BrayLab60/Tracker-Solaire/README.md

# Solar Tracker Toolkit 🌞
Bienvenue dans le Solar Tracker Toolkit, une aventure technologique où la créativité rencontre la durabilité. Ce kit a été spécialement conçu pour vous guider pas à pas dans la conception, l'assemblage et la programmation de votre propre système de suivi solaire automatisé.

À travers une approche pratique et collaborative, vous apprendrez à maîtriser toutes les étapes de fabrication d’un tracker solaire performant, en utilisant des matériaux recyclés et des technologies accessibles comme Arduino et divers capteurs. Que vous soyez débutant ou que vous ayez déjà une expérience en domotique, en électronique ou en programmation, ce toolkit s’adapte à tous les niveaux.

Non seulement vous construirez un prototype fonctionnel, mais vous plongerez également dans des réflexions sur les défis environnementaux, les énergies renouvelables et l’innovation durable. Notre objectif ? Vous offrir les compétences pour imaginer et créer des solutions qui contribuent à un avenir plus vert 🌍.

Alors, prêt à maximiser l’efficacité de l’énergie solaire tout en développant vos talents en électronique, mécanique et programmation ? Le défi commence ici !
