BrayLab60/Tracker-Solaire/(commit log)

2024-09-30 Construire le code du tracker solaire pour Arduinono.ino
2024-09-30 Create Récupérer et stocker l’information du capteur à effet hall.ino
2024-09-30 Rename c. Construire le code du tracker solaire pour Arduinono.ino to Construire le code du tracker solaire pour Arduinono.ino
2024-09-30 Create Piloter les relais pour faire tourner le moteur.ino
2024-09-30 Create Faire la différence entre les deux mesures de photorésistance et actionner le moteur en fonction.ino
2024-09-30 Create Intégrer la sécurité avec le capteur à effet Hall si une limite est atteinte.ino
2024-09-30 Create Définir un seuil de luminosité sous lequel le tracker ne tourne plus (mode nuit).ino
2024-09-30 Create Étape 1 : Récupérer et stocker les informations sur les photorésistances.ino
2024-09-30 Rename Récupérer et stocker l’information du capteur à effet hall.ino to Étape 2 : Récupérer et stocker l’information du capteur à effet hall.ino
2024-09-30 Rename Piloter les relais pour faire tourner le moteur.ino to Étape 3 : Piloter les relais pour faire tourner le moteur.ino
2024-09-30 Rename Faire la différence entre les deux mesures de photorésistance et actionner le moteur en fonction.ino to Étape 4 : Faire la différence entre les deux mesures de photorésistance et actionner le 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
2024-09-30 Rename Intégrer la sécurité avec le capteur à effet Hall si une limite est atteinte.ino to Étape 6 : Intégrer la sécurité avec le capteur à effet Hall si une limite est atteinte.ino
2024-09-30 Rename Définir un seuil de luminosité sous lequel le tracker ne tourne plus (mode nuit).ino to Étape 7 : Définir un seuil de luminosité sous lequel le tracker ne tourne plus (mode nuit).ino
